davidomanovic/Arduino-Projects/Electronic device with heat and humidity control/Electronic device with heat and humidity regulation for proofing bread and pastry.pdf

# Electronic device with conditionally autonomous heat and humidity regulation for proofing bread and pastry

## David Omanovic, Denis Lobe

June 10, 2024

Department of Natural Sciences, Norwegian University of Science and Technology, NO-7491 Trondheim, Norway

Abstract

We describe an electronic system housed in a polypropylene box, equipped with an incandescent light bulb to create a warm environment necessary for proofing bread and pastry. The system utilizes a micro-controller unit, specifically the Arduino UNO, in conjunction with a relay system to manage both digital and analog signals, facilitate user interaction, and operate within a voltage range of 5V to 230V (50Hz AC). The autonomous systems of the device is implemented with C++ scripting, sensor data, communicated through an Arduino UNO. However, the mechanical design, use of materials, and the use of a light bulb significantly limits efficiency and results in energy losses, rendering the product less sustainable.

## 1 Introduction

To make bread you need a yeast and bacteria culture that can make your bread rise and ferment. In normal conditions like room temperature in your kitchen and low humidity, the potential rise and development of flavour is inconsistent. A way of ensuring consistent fermentation is crucial to get consistent results. The fermentation process is also quite tedious and slow in normal conditions. For that reason, a humid, warm and controlled environment like in a "proofing chamber", will accelerate the process. The largest volume increase in dough is anything around six hours [1].
A somewhat of a indicative technique to distinguish over/underproofing is by looking at the crumb structure. Using a proofing chamber, we wish to land on the middle row of the nicely fermented crumbs as we can see in figure 1 (most preferably the last one to the right). With a consistent temperature, you will minimize the chances for fermentation issues. Rules of thumb, like checking volume rise, springiness in the dough or just following a time-based recipe will not suffice if the environment is constantly changing. A constant temperature is achievable through a closed thermal system that regulates the heat. This project utilizes a plastic box and a light bulb as heat.

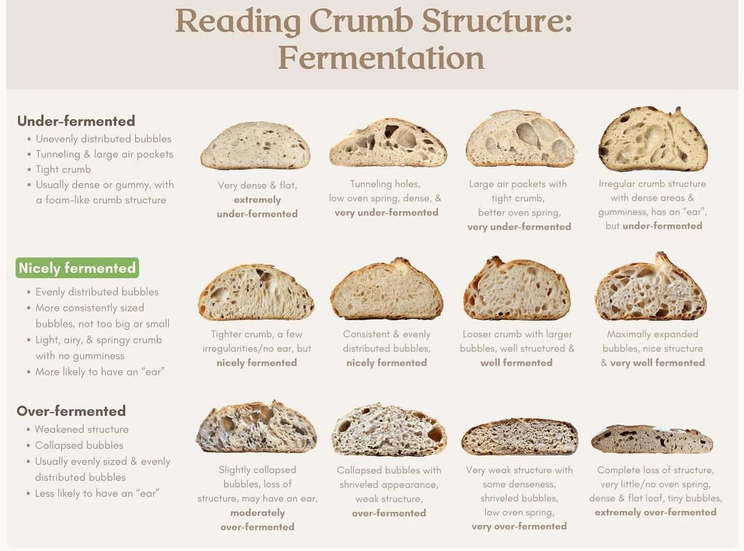
[picture p1: figure]

Figure 1: Different types of crumb structures specifically for sourdough loaf and how to read them [2].

## 2 Method

## 2.1 Mechanical build

A polypropylene box (storage box from Clas Ohlson) with dimensions of 59 × 39, 5 × 24, 5 cm, as seen in figure 2, is the outer body/chassis of the proofing chamber where the dough will reside. The electronics is hidden underneath a black 3D printed box that is on top of the polypropylene lid (c.f. fig. 2). Holes are drilled in the black box for the buttons and display, with male-to-female connectors for each pin of the components drilled into the roof. The polypropylene lid also has a hole to insert the E27 light bulb socket, with belonging cable to power the heating element. The cable for the wall outlet plug comes through a hole at the back of the black box. With our 60W incandescent light bulb, we would reach our desired temperature in about 5 minutes if we want

### an increment of 5

### ◦C, for instance from room temperature 22◦C to 27◦C by using simple thermal

equilibrium approximations and calculations with heat capacities. In this case, we use the fact that q = mCs∆T, where q is the heat added, Cs is the specific heat capacity of the material, and ∆T is the temperature change [3]. For a clean and user-friendly design, we use a battery inside as a power source with a red latching switch at the top left corner (c.f. fig. 2).

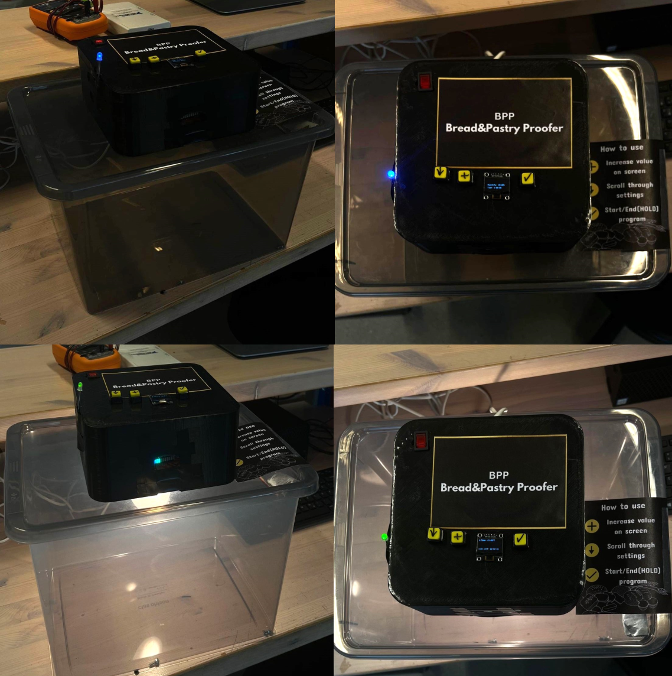
[picture p2: figure]

Figure 2: Build of the box as a polypropylene box for the dough to rest inside and 3D printed black box at the top for the electronics. At the top of the black box is the user interface, OLED display, buttons and power switch. Blue LED indicates settings menu, Green LED indicates that program is running.

## 2.2 Software

The software part is easily implemented with some logic programming in Arduino C. You start off at a menu screen, you scroll through options and pick your desired temperature and desired time for the program to run. For the electric circuit, we are controlling our heat and humidity by first setting input variables for desired temperature, humidity and time. After starting the program, the output temperature and humidity will be displayed on the LCD and the time will start a countdown. If we reach undesirable values, the heating elements turns off to release heat and turns on again as we reach a lower temperature. In this way, we should approximately stay at thermal equilibrium at the user input temperature. As the time is counted down to zero, the whole programs turns off and the user gets sent back to the main menu. The entirity of the code for the Arduino is given in Appendix A at page 8-12, and the methods for controlling pins and much more are found in "Arduino Projects" [4]. Respectively, we have libraries and manuals for the DHT11 sensor and SSD1306 display from AdaFruit, which you can download from Arduino IDE directly.

## 2.3 Electrical connections

The device works as a simple feedback system using the Arduino UNO as the control operator and the temperature/humidity sensor as the input device. Additionally, the LED lights and screen functions as a human guide for the operation of this device in the form of a user interface (UI).

Table 1: Electrical components for proofing chamber with recommended voltages and currects. Note that the circuit consists of AC and DC sources.

Component | Vin/Vout (recommended)
Arduino UNO | 7-12 V DC
Adafruit SSD1306 - I2C OLED 0.96" 128 × 64 | 3-5 V DC
DHT11 - temp & humid sensor | 3-5.5 V DC
60W OSRAM Incandescent bulb | 230V AC (50Hz)
Procell - Alkaline Battery | 9 V DC
Relay Module JQC-3FF-S-Z | 5V/230V AC (50Hz)
Restored E27 light bulb socket | 230V AC (50 Hz)
2x 74HC595 Shift Register | 2-6V DC
SMD RGB LED | 1.8-3V DC
RGB LED Bar Graph | 1.8-3V DC

Table 2: Pin connections for components to the Arduino UNO. ’D’ is the digital channels, which are either input or output pinmodes on the Arduino. ’A’ indicates the analog channels.

Component | Pinout | Arduino Pin
SSD1306 Display | Vin | 5V
SSD1306 Display | GND | GND
SSD1306 Display | SCL | A1
SSD1306 Display | SDA | A2
Tactile switch (+) | Vin, GND | D2, GND
Tactile switch (-) | Vin, GND | D3, GND
Tactile switch (OK) | Vin, GND | D4, GND
Relay module | IN | D5
Relay module | Vcc | 5V
Relay module | GND | GND
DHT11 sensor | Data | D6
DHT11 sensor | Vcc | 5V
DHT11 sensor | GND | GND
Red - RGB LED + 470Ω | Anode | D7
Green - RGB LED + 470Ω | Anode | D8
Blue - RGB LED + 470Ω | Anode | D9
GND - RGB LED | Cathode | GND
74HC595 | DATA | D10
74HC595 | LATCH | D11
74HC595 | CLOCK | D12
9V Battery | Cathode | Vin
9V Battery | Anode | GND

Table 3: Pin connections for components to components.

From | Pinout from | To | Pinout to
E27 Socket | Vsupply | Relay | COM
E27 Socket | Neutral (N) | Relay | NO
9V Battery | Cathode (+) | Latching switch | Arduino Vin
9V Battery | Anode (-) | Arduino UNO | GND

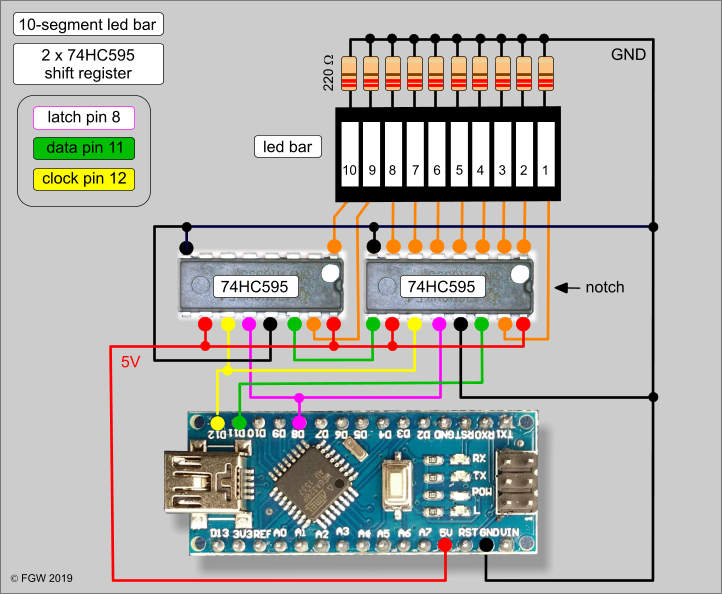
[picture p3: figure]

Figure 3: Shift register wiring diagram retrieved from [5]. Two 74HC595, 10x 220Ω resistors and the 10-segment led bar connected to an MCU like Arduino UNO. Latch pin 8 updates the LED states by transferring data from the shift register to the output pins upon receiving a high signal. Data pin 11 receives the serial data that determines the on/off states of the LEDs, one bit per LED. Clock pin (SRCLK) advances the shift register by one position with each pulse, allowing sequential data entry from data pin.

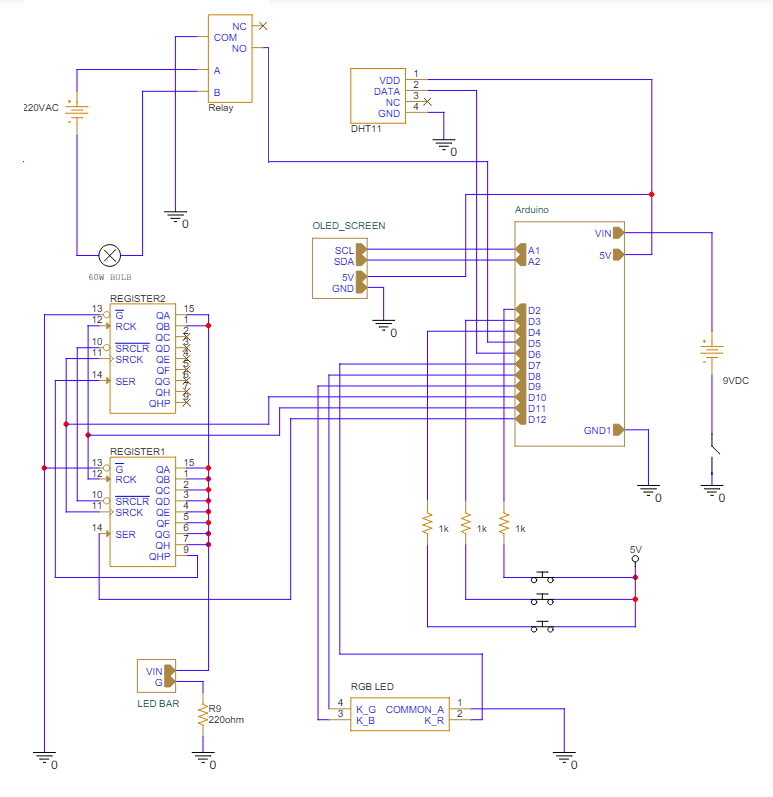
[picture p4: figure]

Figure 4: Circuit schematics of figure 5 and tables 2, 1, 3 constructed in OrCAD™ software.

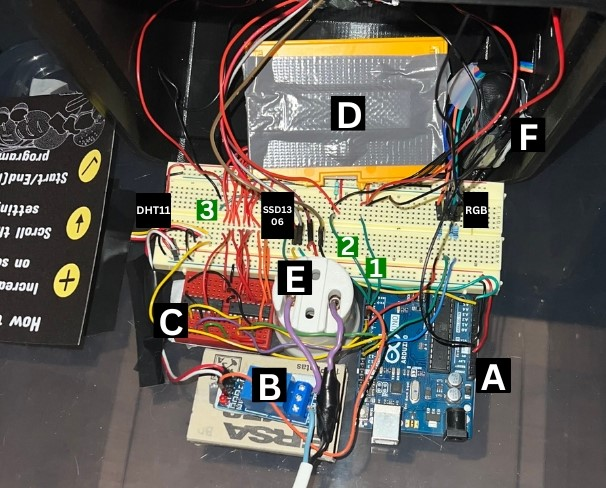
[picture p5: figure]

Figure 5: (A) Arduino UNO pinout connections as in table 2. (B) Relay Module listed in table 1 connected as in table 3. (C) 8-bit shift register using two 74HC595 to control the 10-segment led bar for heat indication, software logic in Appendix A, p.12, line 292-337. (D) The 10-segment led bar connected with 10x 220Ω resistors to cathode legs, and rest connects to (C) as schematics in figure 3. (E) E27 bulb socket connected to the relay module, screwed into the box and plugged into wall outlet of 230V. (F) 9V battery plugged into a switch at the top of the lid so user can manually turn off the device without plugging out of the wall, anode goes to Arduino Vin and cathode to GND. (1) OK button, tactile switch with logic in Appendix A, p. 11, line 238-246. (2) Scroll button, tactile switch with logic in Appendix A, p.11, line 248-256. (3) Increment/Plus button, tactile switch with logic in Appendix A, p.11, line 260-268. DHT11 is the temperature and humidity sensor, SSD1306 is the OLED display, and RGB is the RGB Micro LED component for program indication. These three components are connected in accordance to table 1.

## 3 Results and discussion

The price of the device lands on about 300,- NOK with an Arduino UNO, all electrical components and the plastic boxes. This is good news since similar products at the market costs up to 2500,-

### NOK. The device does indeed use about 5 minutes to heat up from 22◦C to 27◦C as stated in the method. We have tested, and it can easily go up to higher temperatures like 32◦C. The

regulation technique for the temperature works fairly well as simply as turning the bulb on and off by closing the relay. From sensor readings, the environment will reach a thermal equilibrium as the temperature reaches what the user has picked as input. It could be a bit annoying that the light turns on and off every minute. Take for instance that the user picked a temperature of 27◦C. The

### code is constructed such that if the system hits 27.0

### ◦C, it turns off and then on again immediately as the DHT11 registers 26.9

◦

### , which happens frequently in this case. An easy fix is implementing a threshold of ±0.5

### ◦C in the software, letting it heat up over the input temperature, and cool down

more. Despite the good heating capabilities, a poor insulator like our very thin chassis build in polypropylene plastic suffers loss of heat. The budget severely affects its efficiency. The box is easily heated up, but does waste a lot of energy in the long run, which is not sustainable. On the other hand, when it comes to the finished product, it is apparent that it makes a difference in bread and pastry proofing. Comparing bread without using the bread proofer and after using the bread proofer, shows a noticable difference in the quality of the fermentation as seen in figure (6).

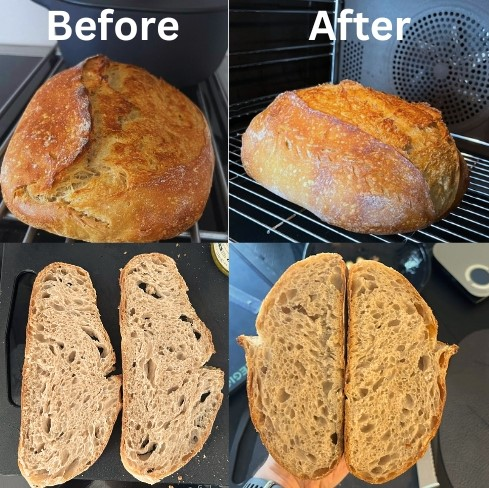
[picture p6: figure]

Figure 6: To the left (Before) a sourdough loaf is baked without proofing and fermentation in the environments of the box. (Before) was proofing at the kitchen bench at approximately 22◦C for 8 hours and 12 minutes. To the right (After), the loaf proofed constantly at 27◦C for 5 hours and 25 minutes. It is apparent that it takes almost half the time, and also ferments the dough in an even and controlled way, resulting in an uniform crumb structure. It subjectively tastes better with better fermentation as well.

Another issue with the design of the product is that all the electrical components are on the lid/roof of the polypropylene box (c.f fig. 5), essentially right next to the heating element. The second issue that arises by being on the lid of the box, is that the light bulb is also placed on top of the lid. In this sense, the breadboard and arduino also receive heat from the bulb, which can damage and wear out the electrical components. Even though the operating temperature is up to 85◦C for the Arduino UNO, as specified by the official Arduino support page [6], it is not a safe environment to keep the rest of the components and for user. For that reason, it is not recommended to use the program for more than a couple of hours. Luckily, with higher temperatures it is not neccessary to proof for longer than four to five hours, whereas it would otherwise take anything between eight to 12 hours at the kitchen bench [1]. Another design flaw is that most components are taped down with duct tape for modularity purposes, but poses a risk of loosening.
A design improvement could be to have a slim heating element instead of a light bulb that is isolated at the bottom of the box, and have the electronics in a small seperate box that is glued to the front of the proofing box. There was a lack of resources to make this mechanical work less demanding, so the only viable option was to use a 3D printed plastic box at the top of the lid with cables hanging down from it. Another nice additional functionality would be some sort of speaker that plays a noise as the program is done, or if its too hot.

The program cycle works as promised and is user friendly. A demonstration of how the heating works is illustrated in figure 7. The led bar graph solution is slightly unstable as some cables can jump out of the breadboard caused from its bad positioning inside the black box. The user has to be careful when lifting the lid, which can be annoying. However, there seems to be no electromagnetic interference despite all of the connections, indicating good isolation. Most of the issues arise by the fact that the positioning and placements of the electronics are subpar and the lack of space inside the black box. More functionalities, slimmer design and less fuss with wires could be improved by making a PCB or having a 3D printed box with slots where you could easily insert the electronics.

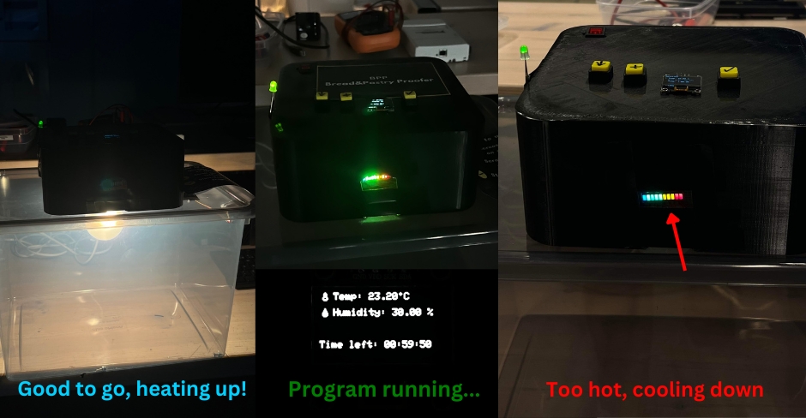
[picture p7: figure]

Figure 7: Example of program running where user has input a certain temperature to heat up to. To the left, user has input values on the settings page, pressed the "OK" button and then the light bulb turns on to heat the box. The middle shows an example of the program running and the OLED display indicating the sensor readings and time left for the program. The led bar segment to the right shows that it is too hot and turns off the heating element until the sensor registers that it is under the user input temperature.

## 4 Conclusion

Our conclusion is clear and the Bread proofer is far away for an ideal and efficient baking instrument. However, through trial and error, the project has given valuable information regarding how a micro controller with a simple feedback control system can be applied in a practical environment. For future applications one can apply a more suitable insulation box, or a mechanism that regulates the humidity in a better fashion. Therefore, this experiment can be used as a good example for future uses and applications, and is a good fundamental basis to heating systems. A good out-come is that a typical proofer costs up to 2500,- NOK, but this proofer landed at a tenth of the price.

## References

[1] K. S. Aplevicz, P. J. Ogliari, E. S. Sant’Anna, Influence of fermentation time on characteristics of sourdough bread, Brazilian Journal of Pharmaceutical Sciences 49(2):233-239, (https://www.researchgate.net/publication/270405374_Influence_of_fermentation_time_on_characteristics_of_sourdough_bread) (2013).
[2] Sourdough Wiki, Reading Crumb, Reddit, Available: r/Sourdough, (https://www.reddit.com/r/Sourdough/wiki/reading_crumb/) Accessed: March 20th, 2024, (2024)
[3] H.D. Young, R.A. Freedman, University Physics, (Pearson, 14th ed., 2015).
[4] S. Fitzgerald, M. Shiloh, The Arduino Projects book, in Arduino UNO starter kit, (Torino, Italy, 2012).
[5] F. Wouterlood, Two ways to control a ten-segment led bar with an Arduino, thesolaruni-verse.wordpress.com, (https://thesolaruniverse.wordpress.com/2019/11/16/two-ways-to-control-a-ten-segment-led-bar-with-an-arduino/) (2019).
[6] Arduino Support, What is the operating temperature range for Arduino boards?, Available: support.arduino.cc, (https://support.arduino.cc/hc/en-us/articles/360016076980-What-is-the-operating-temperature-range-for-Arduino-boards) Accessed: April 8th 2024, (2024)

Note: Appendix A containing all Arduino code is located at the next following pages.

## Appendix A. Software code

Below the entire Arduino code is given. Note that to implement this, you have to use exactly the same pins as specified from lines 1-24, or change them accordingly. The rest are functionalities.

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

5
6 | // ARDUINO DIGITAL PINOUT
7 | #d e f i n e OLED_RESET −1 // Re se t pin
8 | #d e f i n e BUTTON_PIN 2 | // OK button
9 | #d e f i n e INCREMENT_PIN 3 // Plu s button
10 | #d e f i n e SCROLL_PIN 4 // S c r o l l button
11 | #d e f i n e HEAT_PIN 5 // Relay
12 | #d e f i n e DHTPIN 6 | // DHT s e n s o r
13 | #d e f i n e RED_RGB 7 // Red RGB pin
14 | #d e f i n e GREEN_RGB 8 // Green RGB pin
15 | #d e f i n e BLUE_RGB 9 // Blue RGB pin
16 | #d e f i n e LATCH_PIN 10 // 74HC595 Latch
17 | #d e f i n e DATA_PIN 11 // 74HC595 Data
18 | #d e f i n e CLOCK_PIN 12 // 74HC595 Clock

19
20 | // OLED CONFIGURATION
21 | #d e f i n e SCREEN_WIDTH 128 // OLED di s p l a y width
22 | #d e f i n e SCREEN_HEIGHT 64 // OLED d i s pl a y h ei g h t
23 | #d e f i n e DHTTYPE DHT11 | // DHT 11
24 | DHT dht (DHTPIN, DHTTYPE) ;

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

43
44 | // Small arrow bitmap ( 8 x8 )
45 | s t a t i c c o n s t un si gned ch a r PROGMEM a r r ow Ic on [ ] = {
46 | 0 b00100 , 0 b01110 ,
47 | 0 b11111 , 0 b00100 ,
48 | 0 b00100 , 0 b00100 ,
49 | 0 b00100 , 0 b00100 ,
50 | } ;

51
52 | // Temperature Ic on bitmap ( 8 x8 )
53 | s t a t i c c o n s t un si gned ch a r PROGMEM tempIcon [ ] =
54 | {
55 | 0 b00100 , 0 b01010 ,
56 | 0 b01010 , 0 b01010 ,
57 | 0 b01010 , 0 b10001 ,
58 | 0 b10001 , 0 b01110 ,
59 | } ;

60
61 | // Water D r ople t Ic on bitmap ( 8 x8 )
62 | s t a t i c c o n s t un si gned ch a r PROGMEM w a te r Ic on [ ] =
63 | {
64 | 0 b00100 , 0 b00100 ,
65 | 0 b01110 , 0 b01110 ,
66 | 0 b11111 , 0 b11111 ,
67 | 0 b11111 , 0 b01110 ,
68 | } ;

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

82
83 d i s pl a y . d i s pl a y ( ) ;

84
85 d el a y ( 2 0 0 0 ) ; // Pause f o r 2 s e c o n d s

86
87 d i s pl a y . c l e a r D i s p l a y ( ) ;

88
89 | // START TEMP&HUMIDITY SENSOR
90 | dht . b e gi n ( ) ;

91
92 | // SET DIGITAL PIN MODES AS I /O ARDUINO UNO
93 | // ==========================================
94 | pinMode (BUTTON_PIN, INPUT) ; | // DIGITAL PIN 2
95 | pinMode (SCROLL_PIN, INPUT) ; // DIGITAL PIN 3
96 | pinMode (INCREMENT_PIN, INPUT) ; // DIGITAL PIN 4
97 | pinMode (HEAT_PIN, OUTPUT) ; // DIGITAL PIN 5
98 | pinMode (RED_RGB, | OUTPUT) ; // DIGITAL PIN 7
99 | pinMode (GREEN_RGB, OUTPUT) ; // DIGITAL PIN 8
100 | pinMode (BLUE_RGB, OUTPUT) ; // DIGITAL PIN 9
101 | pinMode (DATA_PIN, OUTPUT) ; // DIGITAL PIN 10
102 | pinMode (LATCH_PIN, OUTPUT) ; // DIGITAL PIN 11
103 | pinMode (CLOCK_PIN, OUTPUT) ; // DIGITAL PIN 12
104 | // ==========================================
105 | c u r r e n t B u t t o n S t a t e = di gi t al R e a d (BUTTON_PIN) ;
106 | displayMenu ( ) ;
107 | }

108
109 // ___ FUNCTION SECTION ___

110
111 // CONTROL "MENU" DISPLAY STATE (HELPER FUNCTION)

112
113 v oid displayMenu ( ) {

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

141

142 | // VALUE CONTROLLER FOR INCREMENT BUTTON
143 | v oid inc remen t ( ) {
144 | swi t c h ( c u r r e n t S e l e c t i o n ) {
145 | c a s e 0 : // Temperature
146 | T_c += 1 ;
147 | i f (T_c > 3 2 ) T_c = 2 2;
148 | break ;
149 | c a s e 1 : // Humidity
150 | H_c += 1 0; // Inc remen t by 10 f o r example
151 | i f (H_c > 8 0 ) H_c = 4 0;
152 | break ;
153 | c a s e 2 : // Time
154 | Time_c += 1 ; // Inc remen t by 1 hour f o r example
155 | i f ( Time_c > 1 2 ) Time_c = 1 ; // Rese t t o 1 i f i t e x c e e d s 12
156 | // Convert Time_c t o s e c o n d s and update i n i t i a l T i m e
157 | i n i t i a l T i m e = Time_c ∗ 3 6 0 0;
158 | break ;
159 | }
160 | }

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

184
185 | // Di s pl a y Humidity Ic on
186 | d i s pl a y . drawBitmap ( 0 , 1 6 , wa te r Icon , 8 , 8 , SSD1306_WHITE) ;
187 | d i s pl a y . s e t C u r s o r ( 1 4 , 1 6 ) ; // S t a r t t e x t r i g h t a f t e r the i c o n
188 | d i s pl a y . p r i n t (F( " Humidity : " ) ) ;
189 | d i s pl a y . p r i n t ( h ) ;
190 | d i s pl a y . p r i n t l n (F( " %" ) ) ;
191 | }

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

215 | // When time i s 0
216 | d i s pl a y . s e t T e x t Si z e ( 1 ) ;
217 | d i s pl a y . s e t C u r s o r ( 0 , 4 2 ) ;
218 | d i s pl a y . p r i n t (F( " | " ) ) ;
219 | d i s pl a y . s e t C u r s o r ( 0 , 4 2 ) ;
220 | d i s pl a y . p r i n t (F( " Program o ve r ! " ) ) ;
221 | d el a y ( 2 0 0 ) ;
222 | d i s p l a y S t a t e = 0 ; // Return t o main menu
223 | }
224 | }

225
226 | // DISPLAY UPDATER (MAIN LOOP FUNCTION)
227 | v oid upd a teDi spl a y ( )
228 | {
229 | d i s pl a y . c l e a r D i s p l a y ( ) ;
230 | i f ( d i s p l a y S t a t e == 0 ) {
231 | RGB( 0 , 0 , 2 5 5 ) ; // Blue a t menu
232 | displayMenu ( ) ;
233 | d i s pl a y . d i s pl a y ( ) ;
234 | } e l s e {
235 | RGB( 0 , 2 5 5 , 0 ) ; // Green du rin g program
236 | di s pl a y S e n s o r R e a di n g s ( ) ;
237 | displayCountdown ( ) ;
238 | d i s pl a y . d i s pl a y ( ) ;
239 | }
240 | }

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

289 | // RGB CONTROLLER (MAIN LOOP FUNCTION)
290 | v oid RGB( i n t r , i n t g , i n t b ) {
291 | d i g i t a lW r i t e (RED_RGB, r & 0 x04 ? HIGH : LOW) ;
292 | d i g i t a lW r i t e (GREEN_RGB, g & 0 x02 ? HIGH : LOW) ;
293 | d i g i t a lW r i t e (BLUE_RGB, b & 0 x01 ? HIGH : LOW) ;
294 | }

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

306
307 | // 10−segment LED bar l o g i c f o r tempe r a tu re i n d i c a t o r
308 | v oid heatBar ( ) {
309 | i n t T = dht . readTemperature ( ) ;

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
